wtarreau/rocking-stand/circuit/stand.brd

## EAGLE design circuit/stand.brd (2019-09-22)

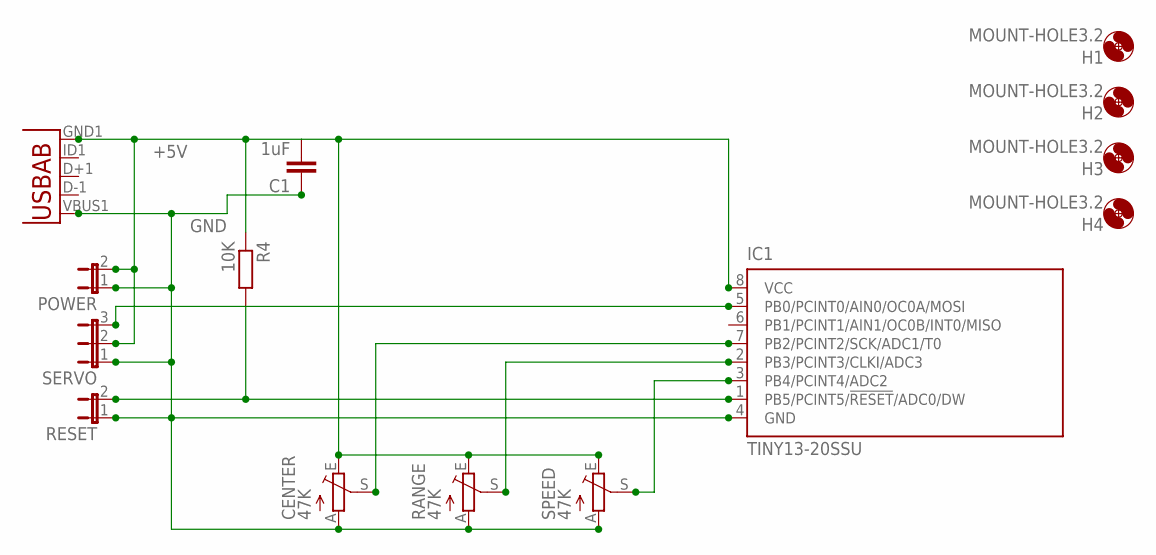
[picture p1: schematic stand.sch]

Parts:
C1: 1uF; C0805
CENTER: 47K; RJ6S
H1, H2, H3, H4: MOUNT-HOLE3.2; 3,2
IC1: TINY13-20SSU; 8S1
POWER: JP1E; JP1
R4: 10K; M0805
RANGE: 47K; RJ6S
RESET: JP1E; JP1
SERVO: JP2E; JP2
SPEED: 47K; RJ6S
U$1: USB""; USB-MICRO-SMD

Connections:
+5V: C1.2, CENTER.E, IC1.8 (VCC), POWER.2, R4.1, RANGE.E, SERVO.2, SPEED.E, U$1.GND1 (GND)
GND: C1.1, CENTER.A, IC1.4 (GND), POWER.1, RANGE.A, RESET.1, SERVO.1, SPEED.A, U$1.VBUS1 (VBUS)
unnamed: IC1.3 (PB4/PCINT4/ADC2), SPEED.S
unnamed: IC1.2 (PB3/PCINT3/CLKI/ADC3), RANGE.S
unnamed: IC1.1 (PB5/PCINT5/!RESET!/ADC0/DW), R4.2, RESET.2
unnamed: IC1.5 (PB0/PCINT0/AIN0/OC0A/MOSI), SERVO.3
unnamed: CENTER.S, IC1.7 (PB2/PCINT2/SCK/ADC1/T0)

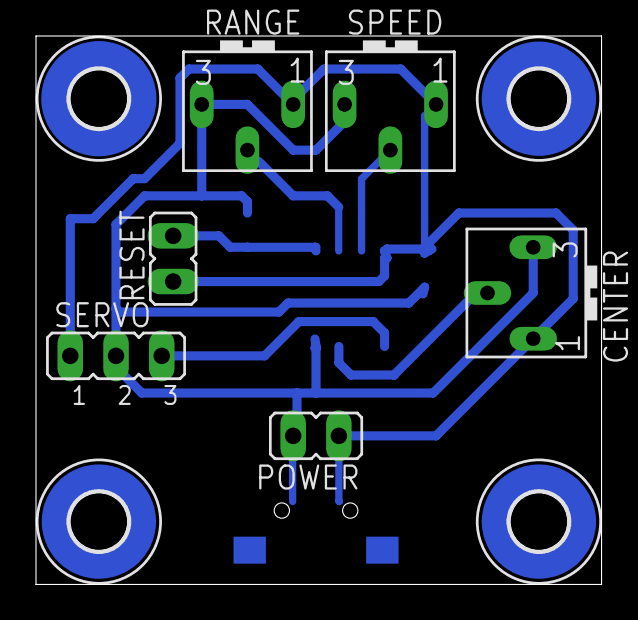
[picture p2: board stand.brd from above]

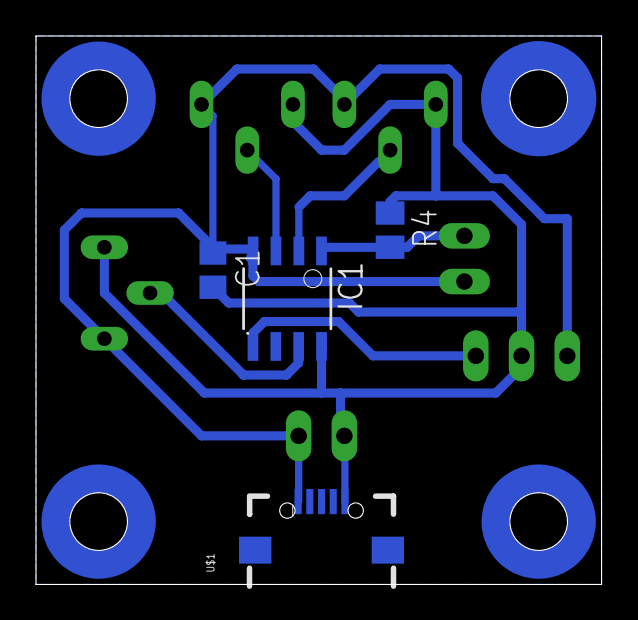
[picture p3: board stand.brd from below]

Board: 2 copper layers, 31.4 x 30.5 mm, 14 parts (4 on the bottom side), 7 nets.
