wtarreau/rocking-stand/experiments/sin+sin2-3rd-quadrant.png

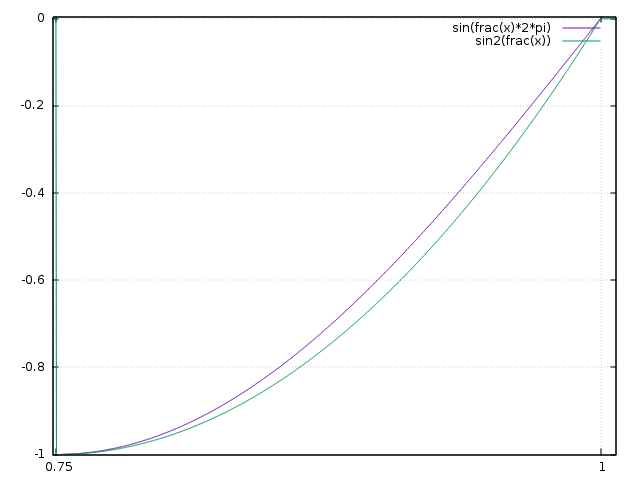
experiments/sin+sin2-3rd-quadrant.png
