wtarreau/rocking-stand/experiments/sin+sin2-final.png

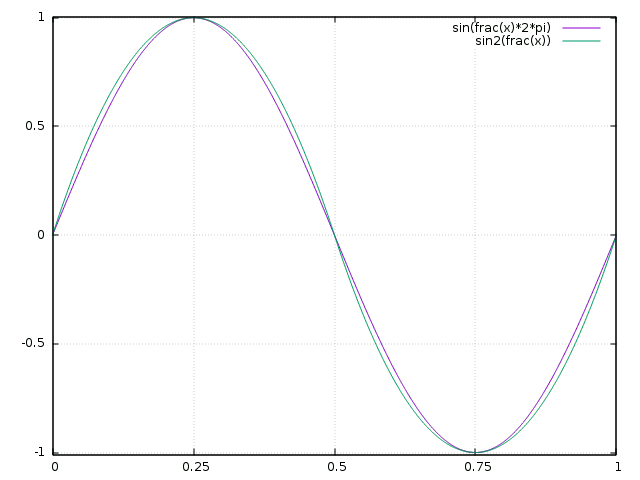
experiments/sin+sin2-final.png
