wtarreau/rocking-stand/experiments/sin+sin2-try1.png

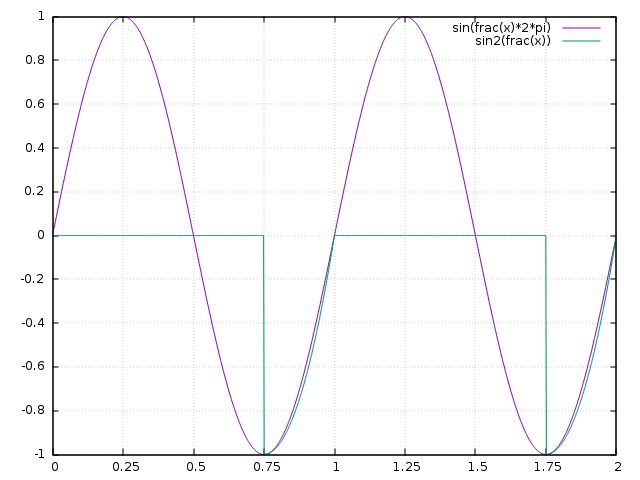
experiments/sin+sin2-try1.png
