wtarreau/rocking-stand/experiments/sin+sin2-try3.png

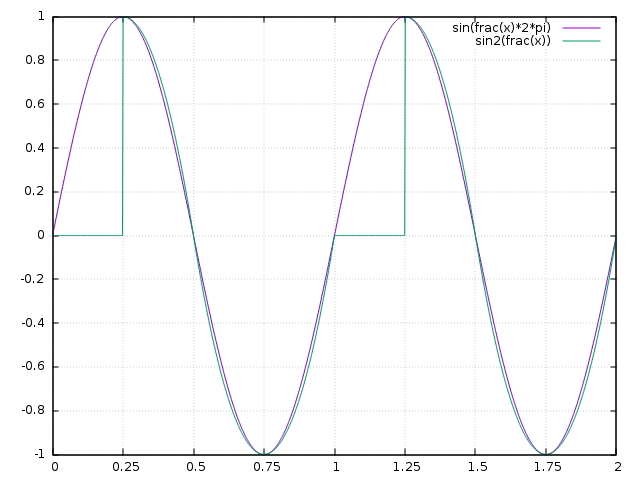
experiments/sin+sin2-try3.png
