wtarreau/rocking-stand/experiments/triangle.png

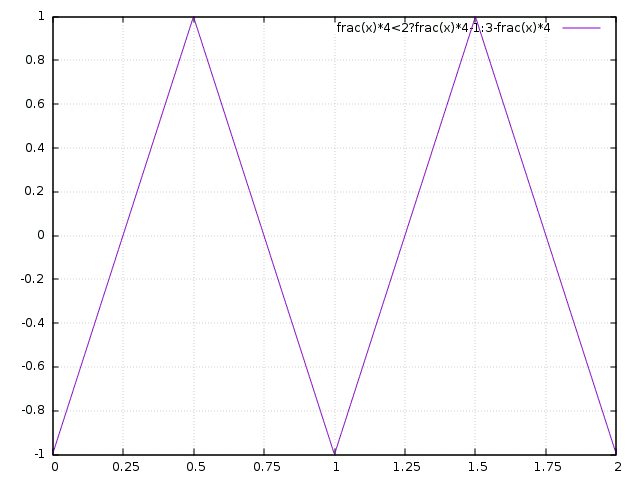
experiments/triangle.png
