wtarreau/rocking-stand/(commit log)

2019-09-22 stand: first version
    This implements a rocking stand to etch PCBs. It is a C reimplementation
    of my earlier 12f675-based one, but with an AVR this time. 3 potentiometers
    are used :
    - p1 = center
    - p2 = speed
    - p3 = amplitude
    This may also be used to test servos and their speed to move in any direction.
    The code is roughly 500 bytes and works equally well in an ATtiny13A or an
    ATtiny85. It is important to note that the timer calibration loop takes 5
    cycles per iteration with gcc 5.4 and 4 with gcc 4.3, so building it with
    gcc 4.3 will not correctly work and will require to change a ratio in the
    us2loops() function.
    [stand.c]
2019-09-22 stand: increase range for the centering
    In order to be able to more easily reuse servos with broken gears, we
    need to cover a larger range for the center. This also requires to
    increase the possible amplitude around the 1500 us center, and in order
    to limit measurement noise, we'll retrieve the full 10-bit ADC values
    for the center and the speed instead of using only 8-bit shifted left,
    which is prone to noise. Now it is possible to make the servo oscillate
    on any area.
    [stand.c]
2019-09-22 circuit: commit the schematic and board
    This is the latest version with 3 potentiometers to adjust :
    - speed
    - range
    - centering
    There's also a jumper to maintain the board in reset state. It can be
    more convenient than unplugging the power supply sometimes.
    [stand.brd, stand.sch]
